flyingperson23/RampedFetCoil/v2/RampedFetCoil.kicad_pcb

## KiCad design v2/RampedFetCoil.kicad_pcb (2025-09-02)

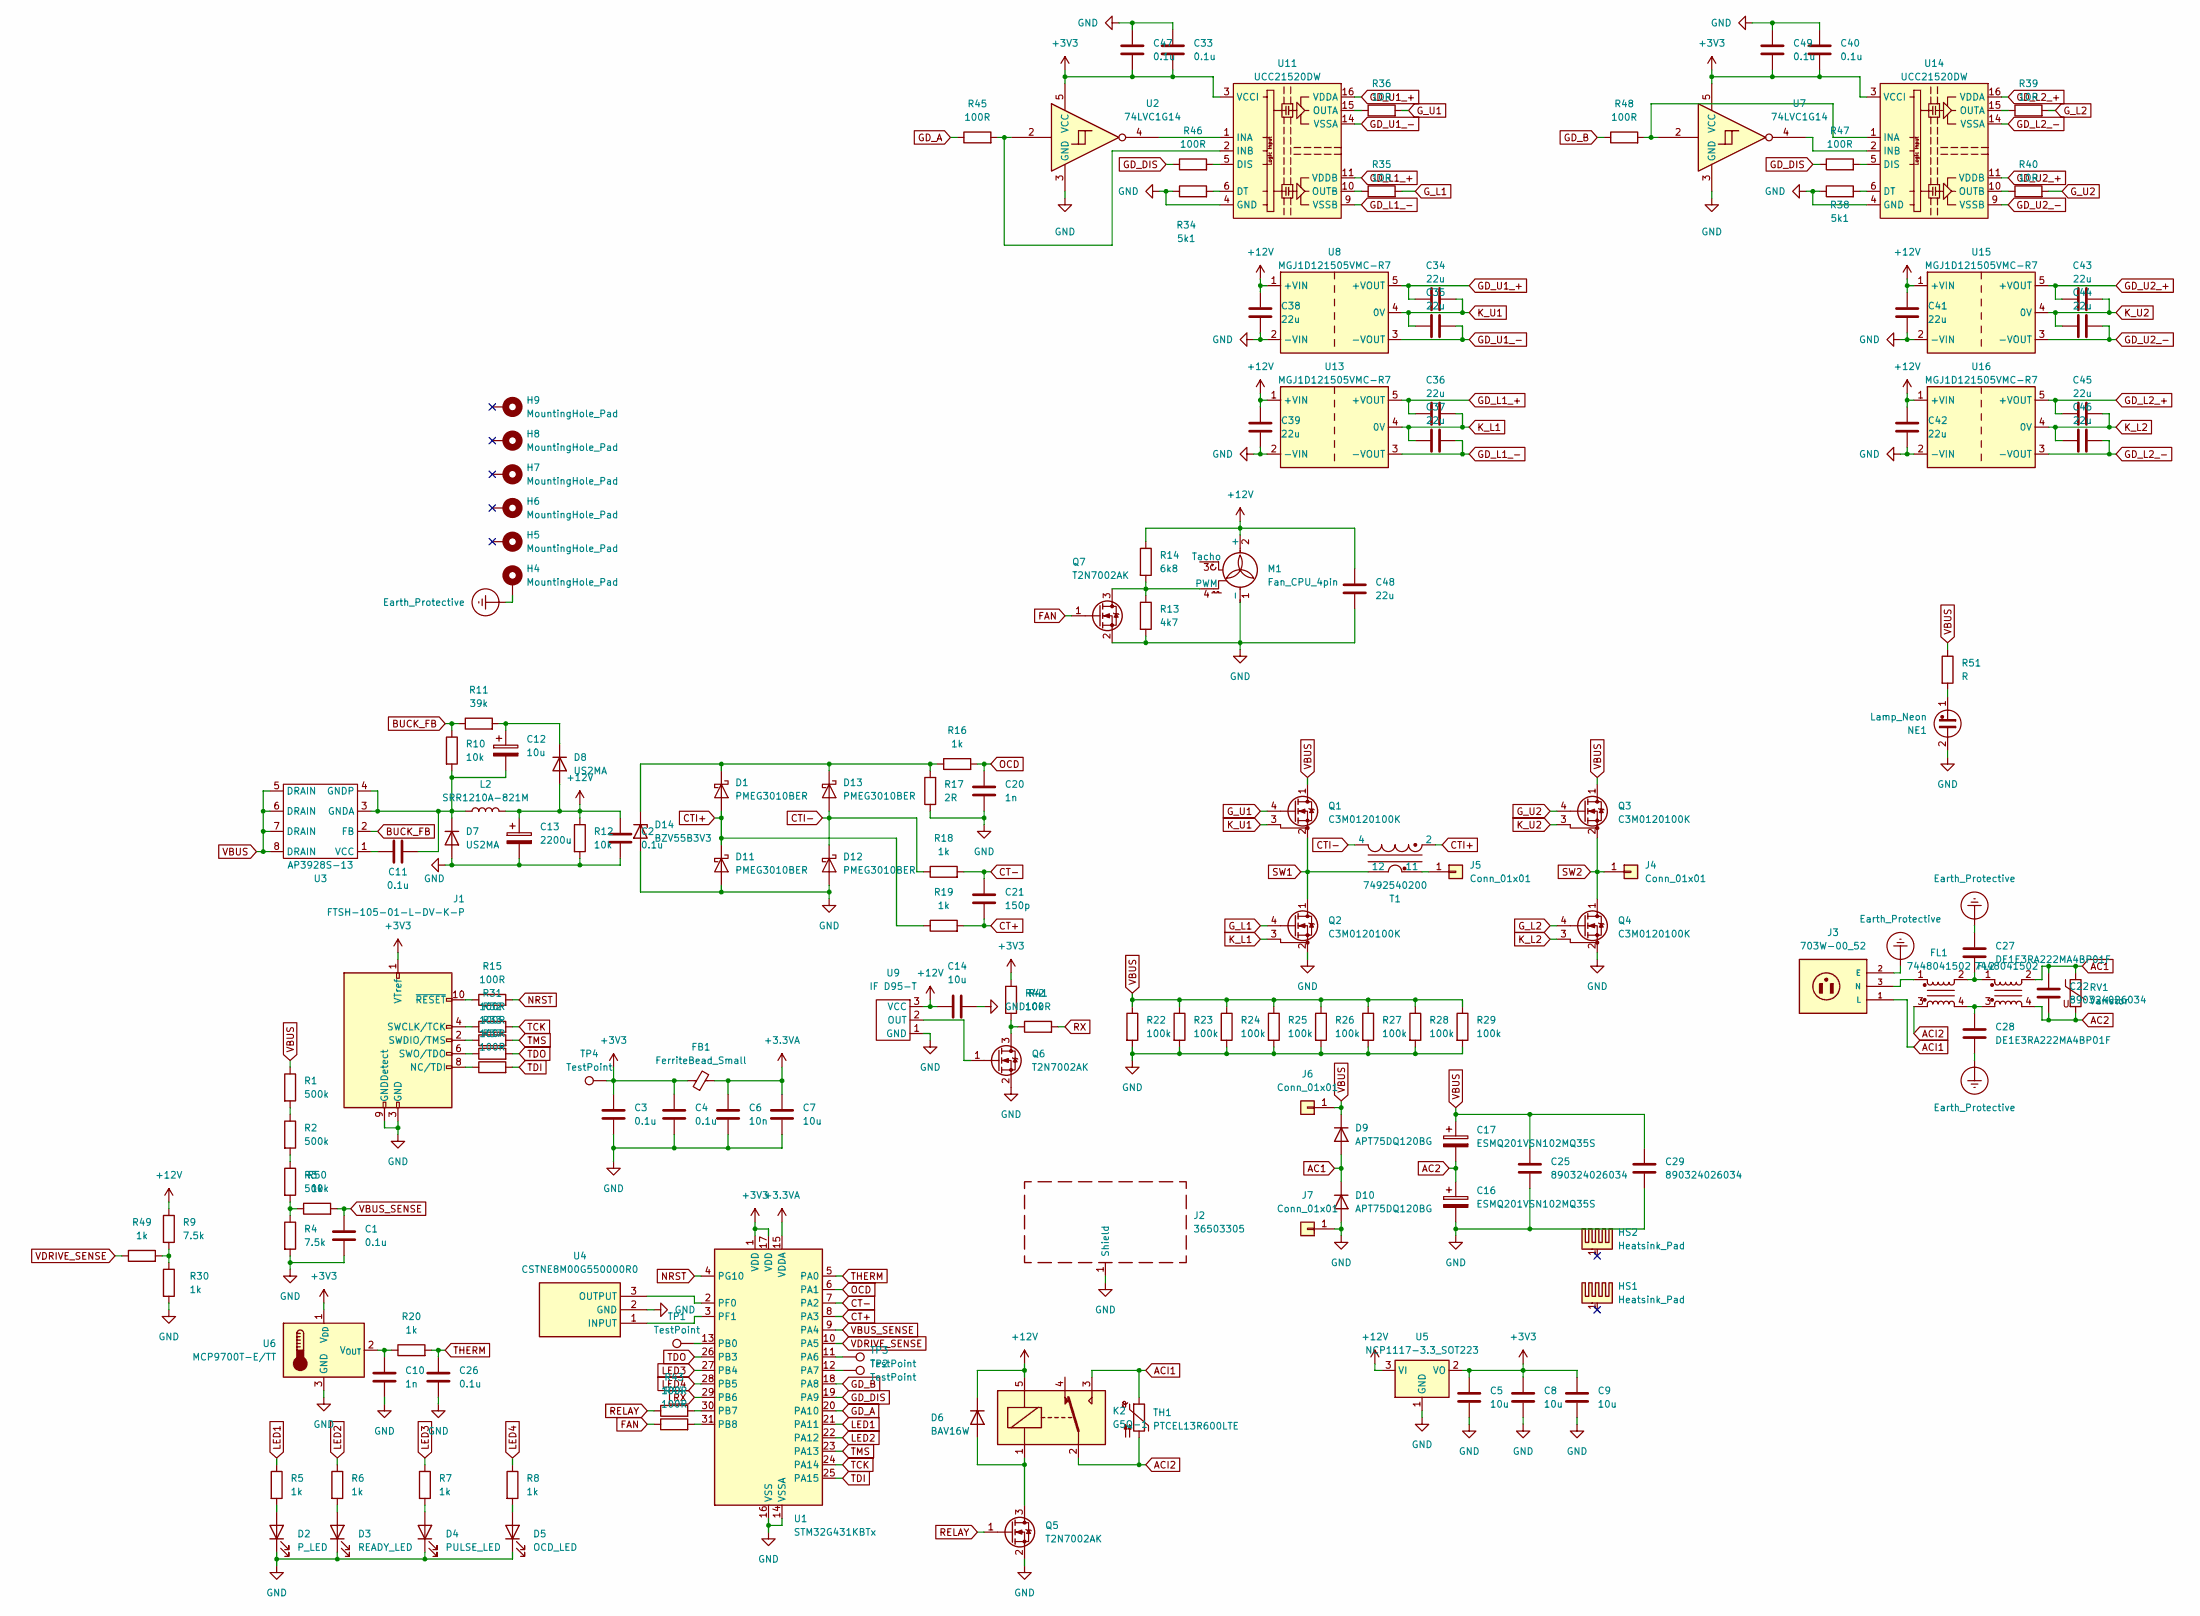
[picture p1: schematic RampedFetCoil.kicad_sch]

Parts:
C1, C2, C3, C4, C11, C26, C33, C40, C47, C49: 0.1u; C_0805_2012Metric
C5, C7, C8, C9, C14: 10u; C_0805_2012Metric
C6: 10n; C_0805_2012Metric
C10, C20: 1n; C_0805_2012Metric
C12: 10u; 860010572002; MPN 860010572002
C13: 2200u; 2m2 25V 860010478021; MPN 860020575013
C16, C17: ESMQ201VSN102MQ35S
C21: 150p; C_0805_2012Metric
C22, C25, C29: 890324026034
C27, C28: DE1E3RA222MA4BP01F
C34, C35, C36, C37, C38, C39, C41, C42, C43, C44, C45, C46, C48: 22u; C_1210_3225Metric
D1, D11, D12, D13: PMEG3010BER; Nexperia_CFP3_SOD-123W
D2: P_LED; LED_0805_2012Metric
D3: READY_LED; LED_0805_2012Metric
D4: PULSE_LED; LED_0805_2012Metric
D5: OCD_LED; LED_0805_2012Metric
D6: BAV16W; D_SOD-123
D7, D8: US2MA; D_SMA
D9, D10: APT75DQ120BG; TO-247-2_Vertical
D14: BZV55B3V3; D_MiniMELF
FB1: FerriteBead_Small; L_0805_2012Metric
FL1, FL2: 7448041502
H4, H5, H6, H7, H8, H9: MountingHole_Pad; MountingHole_4.3mm_M4_Pad_Via
HS1: Heatsink_Pad; C40
HS2: Heatsink_Pad; C40_Half
J1: FTSH-105-01-L-DV-K-P; PinHeader_2x05_P1.27mm_Vertical_SMD
J2: 36503305; Wuerth_36503305_30x30mm
J3: 703W-00_52; QUALTEK_703W-00_52; PARTREV B
J4, J5, J6, J7: Conn_01x01; SPADE_726386-2
K2: G5Q-1; Relay_SPDT_Omron-G5Q-1
L2: SRR1210A-821M; L_Bourns_SRR1210A
M1: Fan_CPU_4pin; FanPinHeader_1x04_P2.54mm_Vertical
NE1: Lamp_Neon; NEON-A1A
Q1, Q2, Q3, Q4: C3M0120100K; TO-247-4_Vertical
Q5, Q6, Q7: T2N7002AK; SOT-23
R1, R2, R3: 500k; R_0805_2012Metric
R4, R9: 7.5k; R_0805_2012Metric
R5, R6, R7, R8, R16, R18, R19, R20, R30, R49, R50: 1k; R_0805_2012Metric
R10, R12, R42: 10k; R_0805_2012Metric
R11: 39k; R_0805_2012Metric
R13: 4k7; R_0805_2012Metric
R14: 6k8; R_0805_2012Metric
R15, R31, R32, R33, R37, R41, R43, R44, R45, R46, R47, R48: 100R; R_0805_2012Metric
R17: 2R; R_2512_6332Metric
R22, R23, R24, R25, R26, R27, R28, R29: 100k; R_2512_6332Metric
R34, R38: 5k1; R_0805_2012Metric
R35, R36, R39, R40: 10R; R_0805_2012Metric
R51: R; R_Axial_DIN0207_L6.3mm_D2.5mm_P2.54mm_Vertical
RV1: Varistor; RV_Disc_D15.5mm_W3.9mm_P7.5mm
T1: 7492540200
TH1: PTCEL13R600LTE; THERMISTOR_PTCEL13_5MM_VIS
TP1, TP2, TP3, TP4: TestPoint; TestPoint_Pad_1.5x1.5mm
U1: STM32G431KBTx; LQFP-32_7x7mm_P0.8mm
U2, U7: 74LVC1G14; SOT-23-5
U3: AP3928S-13; SO-8_3.9x4.9mm_P1.27mm
U4: CSTNE8M00G550000R0; Resonator_SMD_Murata_CSTxExxV-3Pin_3.0x1.1mm; Mouser Part Number 81-CSTNE8M00G550000R
U5: NCP1117-3.3_SOT223; SOT-223-3_TabPin2
U6: MCP9700T-E/TT; SOT-23
U8, U13, U15, U16: MGJ1D121505VMC-R7; MGJ1V
U9: IF D95-T; IF-D95
U11, U14: UCC21520DW; SOIC-16W_7.5x10.3mm_P1.27mm

Connections:
+3.3VA: C6.1, C7.1, FB1.2, U1.15 (VDDA)
+3V3: C3.1, C4.1, C5.1, C8.1, C9.1, C33.2, C40.2, C47.2, C49.2, FB1.1, J1.1 (VTref), R42.2, TP4.1, U1.1 (VDD), U1.17 (VDD), U2.5 (VCC), U5.2 (VO), U6.1 (V_{DD}), U7.5 (VCC), U11.3 (VCCI), U11.8 (VCCI), U14.3 (VCCI), U14.8 (VCCI)
+12V: C2.1, C13.1, C14.1, C38.2, C39.2, C41.2, C42.2, C48.2, D6.1 (K), D8.2 (A), K2.5, L2.2, M1.2 (+), R9.1, R12.1, R14.1, U5.3 (VI), U8.1 (+VIN), U9.3 (VCC), U13.1 (+VIN), U15.1 (+VIN), U16.1 (+VIN)
AC1: C22.1, D9.2 (A), D10.1 (K), FL2.2, RV1.1
AC2: C16.1, C17.2, C22.2, FL2.4, RV1.2
ACI1: J3.1 (L), K2.3, TH1.1
ACI2: FL1.3, K2.2, TH1.2
BUCK_FB: R10.1, R11.1, U3.2 (FB)
CT+: C21.2, R19.2, U1.8 (PA3)
CT-: C21.1, R18.2, U1.7 (PA2)
CTI+: D1.2 (A), D11.1 (K), R19.1, T1.2
CTI-: D12.1 (K), D13.2 (A), R18.1, T1.4
Earth_Protective: C27.1, C28.2, H4.1, J3.2 (E)
FAN: Q7.1 (G), R44.1
GD_A: R45.1, U1.20 (PA10)
GD_B: R48.1, U1.18 (PA8)
GD_DIS: R46.1, R47.1, U1.19 (PA9)
GD_L1_+: C36.1, U11.11 (VDDB), U13.5 (+VOUT)
GD_L1_-: C37.2, U11.9 (VSSB), U13.3 (-VOUT)
GD_L2_+: C45.1, U14.16 (VDDA), U16.5 (+VOUT)
GD_L2_-: C46.2, U14.14 (VSSA), U16.3 (-VOUT)
GD_U1_+: C34.1, U8.5 (+VOUT), U11.16 (VDDA)
GD_U1_-: C35.2, U8.3 (-VOUT), U11.14 (VSSA)
GD_U2_+: C43.1, U14.11 (VDDB), U15.5 (+VOUT)
GD_U2_-: C44.2, U14.9 (VSSB), U15.3 (-VOUT)
GND: C1.2, C2.2, C3.2, C4.2, C5.2, C6.2, C7.2, C8.2, C9.2, C10.2, C13.2, C14.2, C16.2, C20.2, C25.2, C26.2, C29.2, C33.1, C38.1, C39.1, C40.1, C41.1, C42.1, C47.1, C48.1, C49.1, D2.1 (K), D3.1 (K), D4.1 (K), D5.1 (K), D7.2 (A), D10.2 (A), D11.2 (A), D12.2 (A), D14.2 (A), J1.3 (GND), J1.5 (GND), J1.9 (GNDDetect), J2.1 (Shield), J7.1, M1.1 (-), NE1.2, Q2.2 (S), Q4.2 (S), Q5.2 (S), Q6.2 (S), Q7.2 (S), R4.2, R12.2, R13.2, R17.1, R22.2, R23.2, R24.2, R25.2, R26.2, R27.2, R28.2, R29.2, R30.2, R34.1, R38.1, U1.14 (VSSA), U1.16 (VSS), U1.32 (VSS), U2.3 (GND), U4.2 (GND), U5.1 (GND), U6.3 (GND), U7.3 (GND), U8.2 (-VIN), U9.1 (GND), U11.4 (GND), U13.2 (-VIN), U14.4 (GND), U15.2 (-VIN), U16.2 (-VIN)
G_L1: Q2.4 (G), R35.2
G_L2: Q4.4 (G), R39.2
G_U1: Q1.4 (G), R36.2
G_U2: Q3.4 (G), R40.2
K_L1: C36.2, C37.1, Q2.3 (DS), U13.4 (0V)
K_L2: C45.2, C46.1, Q4.3 (DS), U16.4 (0V)
K_U1: C34.2, C35.1, Q1.3 (DS), U8.4 (0V)
K_U2: C43.2, C44.1, Q3.3 (DS), U15.4 (0V)
LED1: R5.1, U1.21 (PA11)
LED2: R6.1, U1.22 (PA12)
LED3: R7.1, U1.27 (PB4)
LED4: R8.1, U1.28 (PB5)
NRST: R15.2, U1.4 (PG10)
unnamed: C27.2, FL1.2, FL2.1
unnamed: C28.1, FL1.4, FL2.3
unnamed: D1.1 (K), D13.1 (K), D14.1 (K), R16.1, R17.2
unnamed: D2.2 (A), R5.2
unnamed: D3.2 (A), R6.2
unnamed: D4.2 (A), R7.2
unnamed: D5.2 (A), R8.2
unnamed: D6.2 (A), K2.1, Q5.3 (D)
unnamed: C11.1, C12.2, D7.1 (K), L2.1, R10.2, U3.3 (GNDA), U3.4 (GNDP)
unnamed: C12.1, D8.1 (K), R11.2
unnamed: J1.8 (NC/TDI), R37.1
unnamed: J1.4 (SWCLK/TCK), R31.1
unnamed: J1.2 (SWDIO/TMS), R32.1
unnamed: J1.6 (SWO/TDO), R33.1
unnamed: J1.10 (~RESET), R15.1
unnamed: FL1.1, J3.3 (N)
unnamed: J5.1, T1.11
unnamed: M1.4 (PWM), Q7.3 (D), R13.1, R14.2
unnamed: NE1.1, R51.2
unnamed: Q6.3 (D), R41.1, R42.1
unnamed: Q6.1 (G), U9.2 (OUT)
unnamed: R1.2, R2.1
unnamed: R2.2, R3.1
unnamed: R3.2, R4.1, R50.1
unnamed: R9.2, R30.1, R49.2
unnamed: TP3.1, U1.11 (PA6)
unnamed: TP2.1, U1.12 (PA7)
unnamed: TP1.1, U1.13 (PB0)
unnamed: R43.2, U1.30 (PB7)
unnamed: R44.2, U1.31 (PB8)
unnamed: U1.2 (PF0), U4.3 (OUTPUT)
unnamed: U1.3 (PF1), U4.1 (INPUT)
unnamed: C11.2, U3.1 (VCC)
unnamed: C10.1, R20.1, U6.2 (V_{OUT})
unnamed: R46.2, U11.5 (DIS)
unnamed: R34.2, U11.6 (DT)
unnamed: U2.4, U11.1 (INA)
unnamed: R45.2, U2.2, U11.2 (INB)
unnamed: R36.1, U11.15 (OUTA)
unnamed: R35.1, U11.10 (OUTB)
unnamed: R47.2, U14.5 (DIS)
unnamed: R38.2, U14.6 (DT)
unnamed: R48.2, U7.2, U14.1 (INA)
unnamed: U7.4, U14.2 (INB)
unnamed: R39.1, U14.15 (OUTA)
unnamed: R40.1, U14.10 (OUTB)
OCD: C20.1, R16.2, U1.6 (PA1)
RELAY: Q5.1 (G), R43.1
RX: R41.2, U1.29 (PB6)
SW1: Q1.2 (S), Q2.1 (D), T1.12
SW2: J4.1, Q3.2 (S), Q4.1 (D)
TCK: R31.2, U1.24 (PA14)
TDI: R37.2, U1.25 (PA15)
TDO: R33.2, U1.26 (PB3)
THERM: C26.1, R20.2, U1.5 (PA0)
TMS: R32.2, U1.23 (PA13)
VBUS: C17.1, C25.1, C29.1, D9.1 (K), J6.1, Q1.1 (D), Q3.1 (D), R1.1, R22.1, R23.1, R24.1, R25.1, R26.1, R27.1, R28.1, R29.1, R51.1, U3.5 (DRAIN), U3.6 (DRAIN), U3.7 (DRAIN), U3.8 (DRAIN)
VBUS_SENSE: C1.1, R50.2, U1.9 (PA4)
VDRIVE_SENSE: R49.1, U1.10 (PA5)

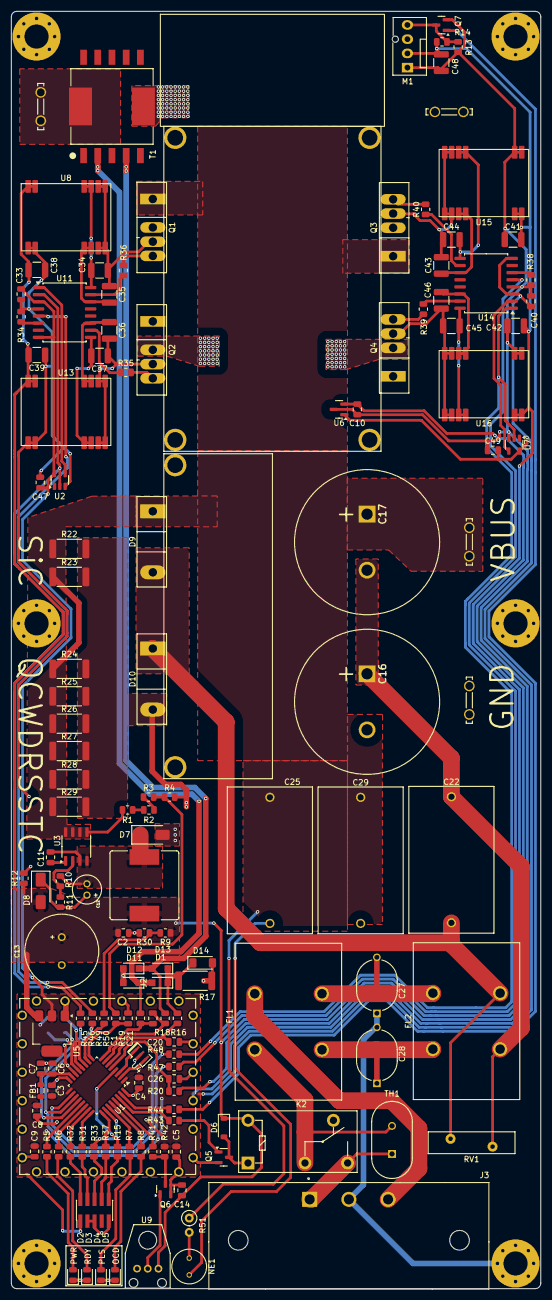
[picture p2: board RampedFetCoil.kicad_pcb from above]

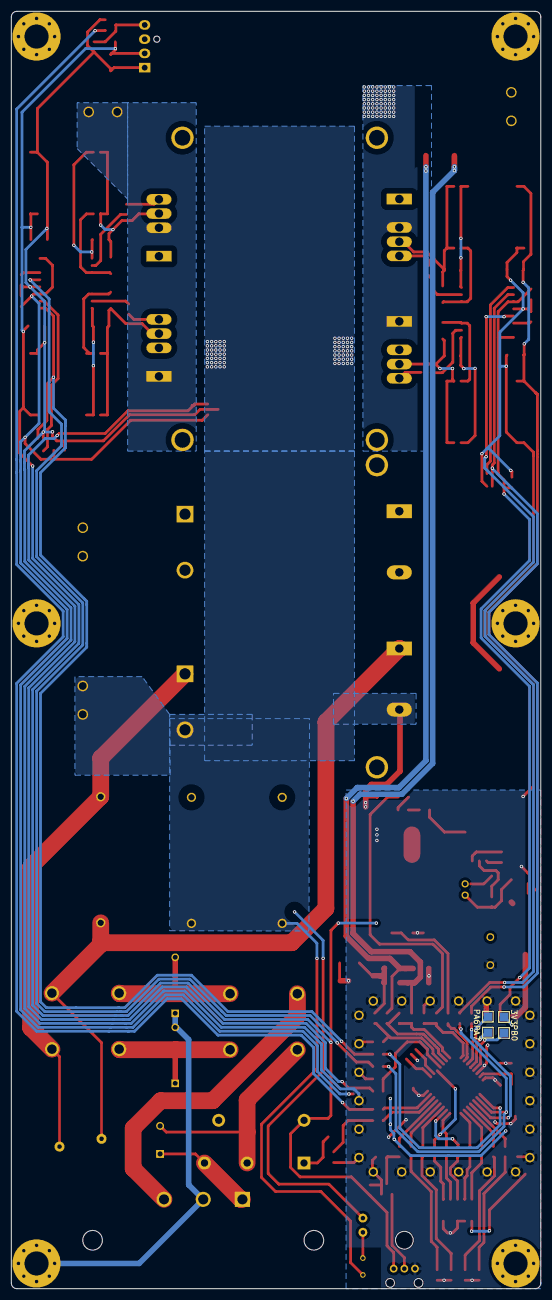
[picture p3: board RampedFetCoil.kicad_pcb from below]

Board: 2 copper layers, 94.5 x 228.0 mm, 155 parts (4 on the bottom side), 98 nets.
