flyingperson23/RampedFetCoil/interrupter/interrupter.kicad_pcb

## KiCad design interrupter/interrupter.kicad_pcb (2025-09-02)

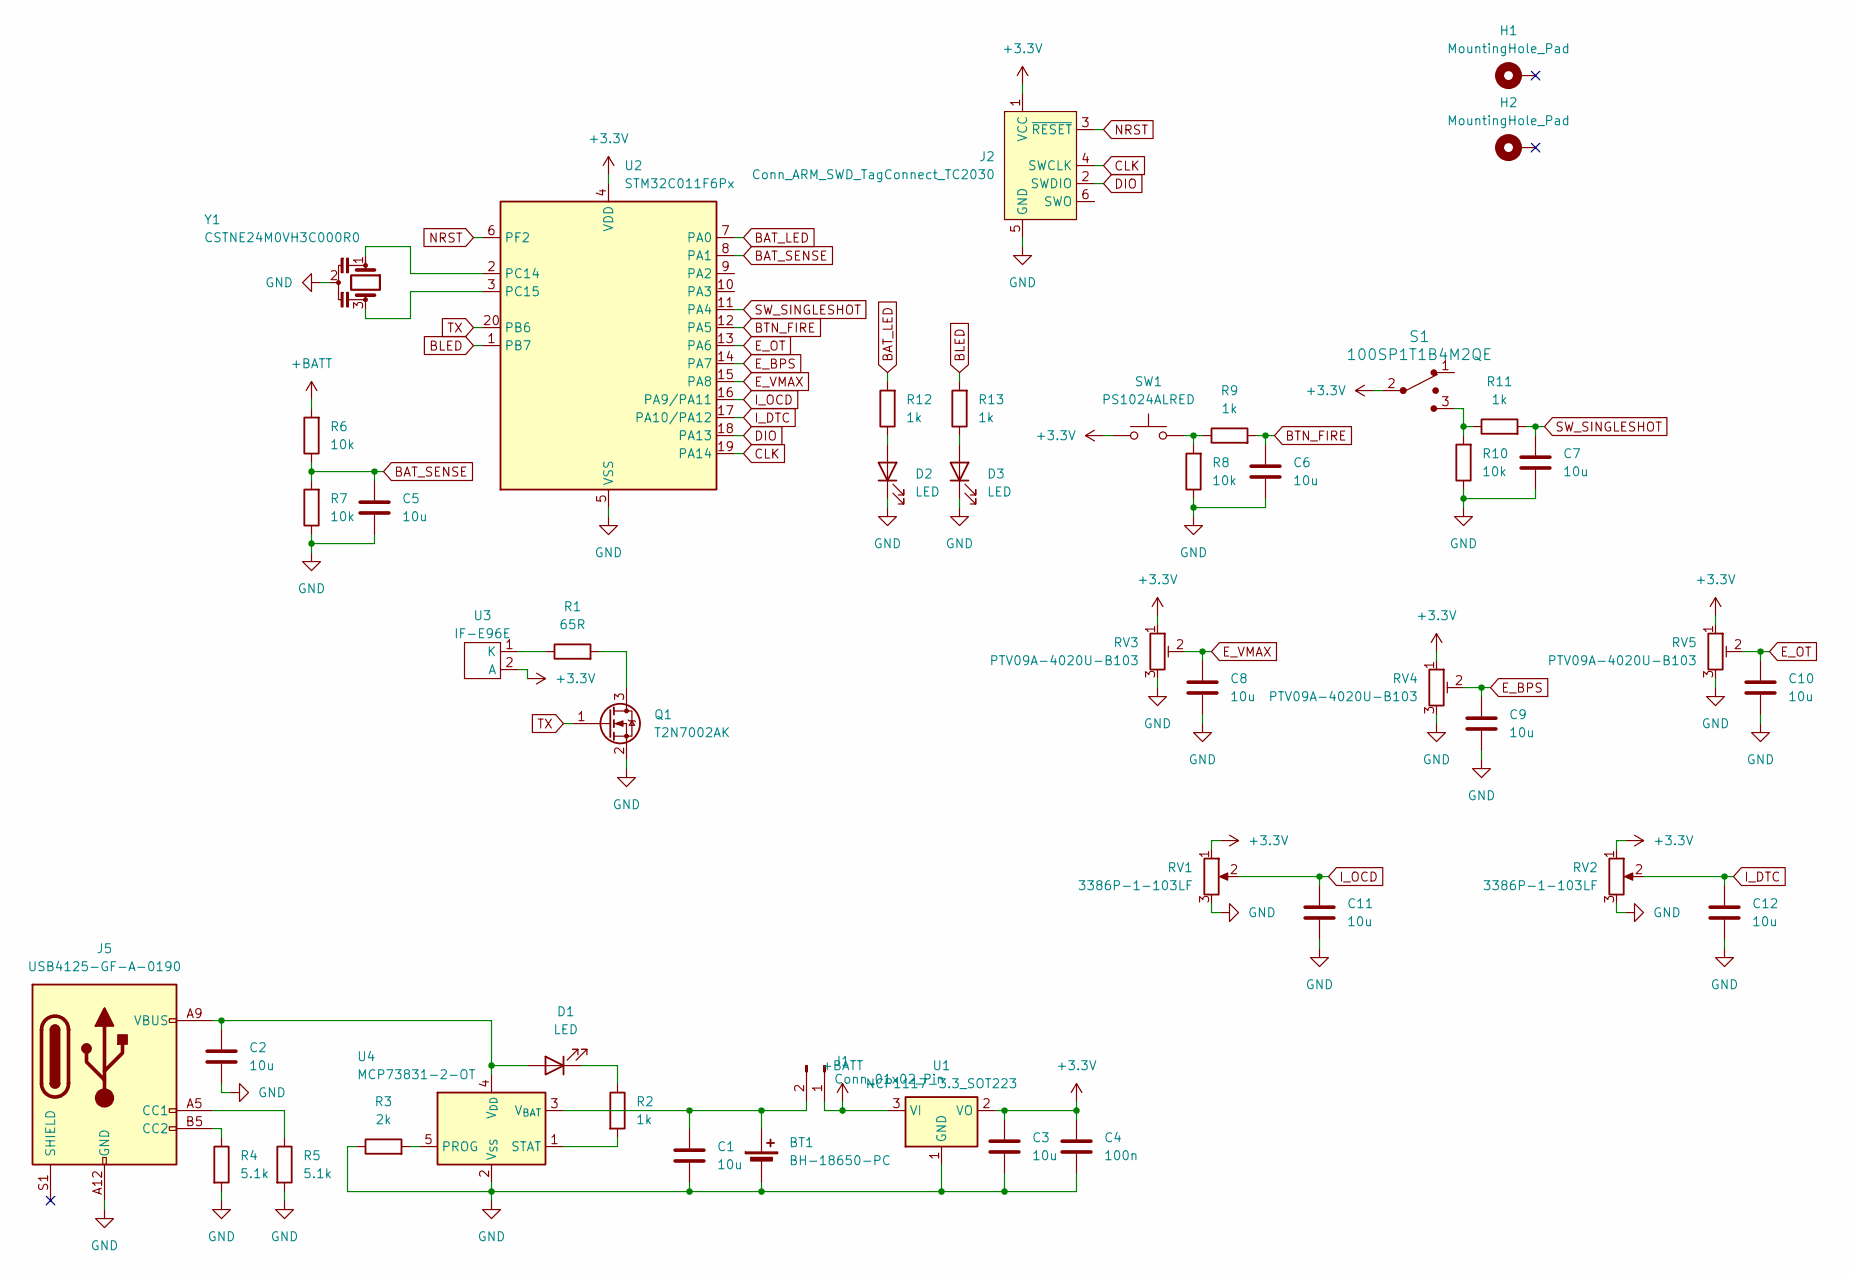
[picture p4: schematic interrupter.kicad_sch]

Parts:
BT1: BH-18650-PC; BatteryHolder_MPD_BH-18650-PC2
C1, C2, C3, C5, C6, C7, C8, C9, C10, C11, C12: 10u; C_0805_2012Metric
C4: 100n; C_0805_2012Metric
D1, D2, D3: LED; LED_0805_2012Metric
H1, H2: MountingHole_Pad; MountingHole_2.7mm_M2.5_Pad_Via
J1: Conn_01x02_Pin; Molex_KK-254_AE-6410-02A_1x02_P2.54mm_Vertical
J2: Conn_ARM_SWD_TagConnect_TC2030; Tag-Connect_TC2030-IDC-FP_2x03_P1.27mm_Vertical
J5: USB4125-GF-A-0190; USB_C_Receptacle_GCT_USB4125-xx-x-0190_6P_TopMnt_Horizontal
Q1: T2N7002AK; SOT-23
R1: 65R; R_0805_2012Metric
R2, R9, R11, R12, R13: 1k; R_0805_2012Metric
R3: 2k; R_0805_2012Metric
R4, R5: 5.1k; R_0805_2012Metric
R6, R7, R8, R10: 10k; R_0805_2012Metric
RV1, RV2: 3386P-1-103LF; Potentiometer_Bourns_3386P_Vertical
RV3, RV4, RV5: PTV09A-4020U-B103; Potentiometer_Bourns_PTV09A-1_Single_Vertical
S1: 100SP1T1B4M2QE; Toggle_Switch_100SP1T1B4M2QE; MPN 100SP1T1B4M2QE; Digi-Key_PN EG2355-ND
SW1: PS1024ALRED; SW_PS1024ALRED
U1: NCP1117-3.3_SOT223; SOT-223-3_TabPin2
U2: STM32C011F6Px; TSSOP-20_4.4x6.5mm_P0.65mm
U3: IF-E96E
U4: MCP73831-2-OT; SOT-23-5
Y1: CSTNE24M0VH3C000R0; Resonator_SMD_Murata_CSTxExxV-3Pin_3.0x1.1mm

Connections:
+3.3V: C3.1, C4.1, J2.1 (VCC), RV1.1, RV2.1, RV3.1, RV4.1, RV5.1, S1.2 (Com), SW1.1, U1.2 (VO), U2.4 (VDD), U3.2 (A)
+BATT: J1.1, R6.2, U1.3 (VI)
BAT_LED: R12.2, U2.7 (PA0)
BAT_SENSE: C5.1, R6.1, R7.2, U2.8 (PA1)
BLED: R13.2, U2.1 (PB7)
BTN_FIRE: C6.1, R9.2, U2.12 (PA5)
CLK: J2.4 (SWCLK), U2.19 (PA14)
DIO: J2.2 (SWDIO), U2.18 (PA13)
E_BPS: C9.1, RV4.2, U2.14 (PA7)
E_OT: C10.1, RV5.2, U2.13 (PA6)
E_VMAX: C8.1, RV3.2, U2.15 (PA8)
GND: BT1.2 (-), C1.2, C2.2, C3.2, C4.2, C5.2, C6.2, C7.2, C8.2, C9.2, C10.2, C11.2, C12.2, D2.1 (K), D3.1 (K), J2.5 (GND), J5.A12 (GND), J5.B12 (GND), Q1.2 (S), R3.1, R4.2, R5.2, R7.1, R8.1, R10.1, RV1.3, RV2.3, RV3.3, RV4.3, RV5.3, U1.1 (GND), U2.5 (VSS), U4.2 (V_{SS}), Y1.2
I_DTC: C12.1, RV2.2, U2.17 (PA10/PA12)
I_OCD: C11.1, RV1.2, U2.16 (PA9/PA11)
NRST: J2.3 (~RESET), U2.6 (PF2)
unnamed: BT1.1 (+), C1.1, J1.2, U4.3 (V_{BAT})
unnamed: C2.1, D1.2 (A), J5.A9 (VBUS), J5.B9 (VBUS), U4.4 (V_{DD})
unnamed: D1.1 (K), R2.1
unnamed: D2.2 (A), R12.1
unnamed: D3.2 (A), R13.1
unnamed: J5.A5 (CC1), R5.1
unnamed: J5.B5 (CC2), R4.1
unnamed: Q1.3 (D), R1.2
unnamed: R8.2, R9.1, SW1.2
unnamed: R10.2, R11.1, S1.3
unnamed: U2.2 (PC14), Y1.1
unnamed: U2.3 (PC15), Y1.3
unnamed: R1.1, U3.1 (K)
unnamed: R3.2, U4.5 (PROG)
unnamed: R2.2, U4.1 (STAT)
SW_SINGLESHOT: C7.1, R11.2, U2.11 (PA4)
TX: Q1.1 (G), U2.20 (PB6)

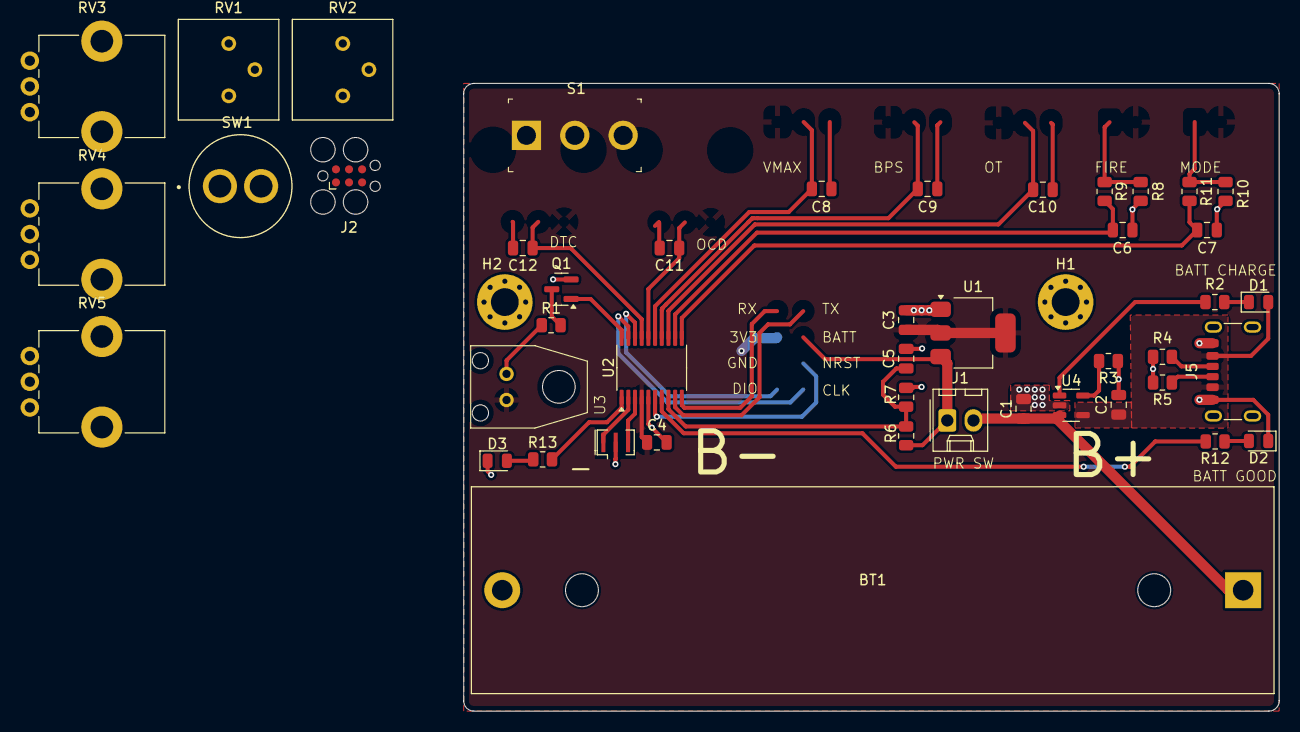
[picture p5: board interrupter.kicad_pcb from above]

Board: 2 copper layers, 79.2 x 61.0 mm, 47 parts (0 on the bottom side), 32 nets.
