flyingperson23/RampedFetCoil/software/STM-QCW.ioc

Mcu.UserName=STM32G431KBTx
PA0.GPIO_Label=THERM
PA0.Signal=ADC1_IN1
PA1.Signal=COMP1_INP
PA10.GPIO_Label=GD_1
PA10.Signal=S_TIM1_CH3
PA11.GPIO_Label=LED1
PA11.Signal=S_TIM4_CH1
PA12.GPIO_Label=LED2
PA12.Signal=S_TIM4_CH2
PA13.Signal=SYS_JTMS-SWDIO
PA14.Signal=SYS_JTCK-SWCLK
PA15.Signal=SYS_JTDI
PA2.Signal=COMP2_INM
PA3.Signal=COMP2_INP
PA4.GPIO_Label=VBUS_SENSE
PA4.Signal=ADC2_IN17
PA5.GPIO_Label=VDRIVE_SENSE
PA5.Signal=ADC2_IN13
PA8.GPIO_Label=GD_2
PA8.Signal=S_TIM1_CH1
PA9.GPIO_Label=GD_DIS
PA9.Signal=GPIO_Output
PB3.Signal=SYS_JTDO-SWO
PB4.GPIO_Label=LED3
PB4.Signal=S_TIM3_CH1
PB5.GPIO_Label=LED4
PB5.Signal=S_TIM3_CH2
PB6.GPIO_Label=RX
PB6.Signal=USART1_TX
PB7.GPIO_Label=RELAY
PB7.Signal=GPIO_Output
PB8-BOOT0.GPIO_Label=FAN
PB8-BOOT0.Signal=S_TIM4_CH3
PF0-OSC_IN.Signal=RCC_OSC_IN
PF1-OSC_OUT.Signal=RCC_OSC_OUT
