flyingperson23/RampedFetCoil/software/Core/Inc/main.h

#define THERM_Pin GPIO_PIN_0
#define THERM_GPIO_Port GPIOA
#define VBUS_SENSE_Pin GPIO_PIN_4
#define VBUS_SENSE_GPIO_Port GPIOA
#define VDRIVE_SENSE_Pin GPIO_PIN_5
#define VDRIVE_SENSE_GPIO_Port GPIOA
#define GD_2_Pin GPIO_PIN_8
#define GD_2_GPIO_Port GPIOA
#define GD_DIS_Pin GPIO_PIN_9
#define GD_DIS_GPIO_Port GPIOA
#define GD_1_Pin GPIO_PIN_10
#define GD_1_GPIO_Port GPIOA
#define LED1_Pin GPIO_PIN_11
#define LED1_GPIO_Port GPIOA
#define LED2_Pin GPIO_PIN_12
#define LED2_GPIO_Port GPIOA
#define LED3_Pin GPIO_PIN_4
#define LED3_GPIO_Port GPIOB
#define LED4_Pin GPIO_PIN_5
#define LED4_GPIO_Port GPIOB
#define RX_Pin GPIO_PIN_6
#define RX_GPIO_Port GPIOB
#define RELAY_Pin GPIO_PIN_7
#define RELAY_GPIO_Port GPIOB
#define FAN_Pin GPIO_PIN_8
#define FAN_GPIO_Port GPIOB
