flyingperson23/RampedFetCoil/(commit log)

2025-04-06 init commit
    [RampedFetCoil-B_Cu.gbr, RampedFetCoil-B_Mask.gbr, RampedFetCoil-B_Paste.gbr, RampedFetCoil-B_Silkscreen.gbr, RampedFetCoil-Edge_Cuts.gbr, RampedFetCoil-F_Cu.gbr, RampedFetCoil-F_Mask.gbr, RampedFetCoil-F_Paste.gbr]
2025-07-08 sicswap 2
    [RampedFetCoil-B_Cu.gbr, RampedFetCoil-B_Mask.gbr, RampedFetCoil-B_Paste.gbr, RampedFetCoil-B_Silkscreen.gbr, RampedFetCoil-Edge_Cuts.gbr, RampedFetCoil-F_Cu.gbr, RampedFetCoil-F_Mask.gbr, RampedFetCoil-F_Paste.gbr]
